ashlin4010/simple_Z80_computer/images/CF_back.jpg

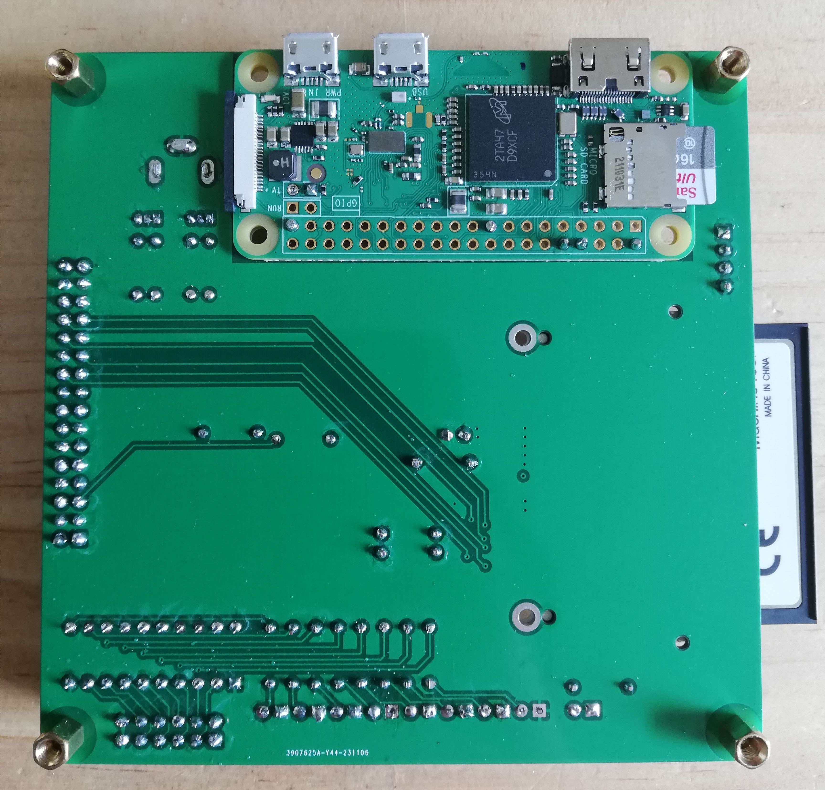
images/CF_back.jpg
