ashlin4010/simple_Z80_computer/images/CF_top.jpg

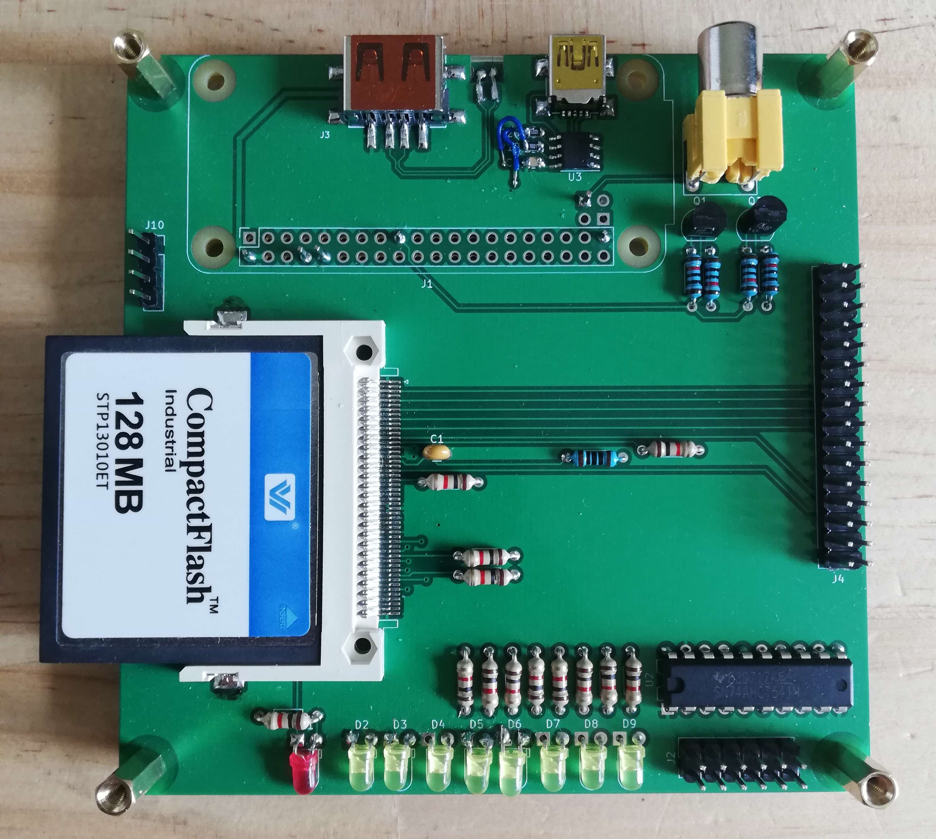
images/CF_top.jpg
