ashlin4010/simple_Z80_computer/images/Z80_back.jpg

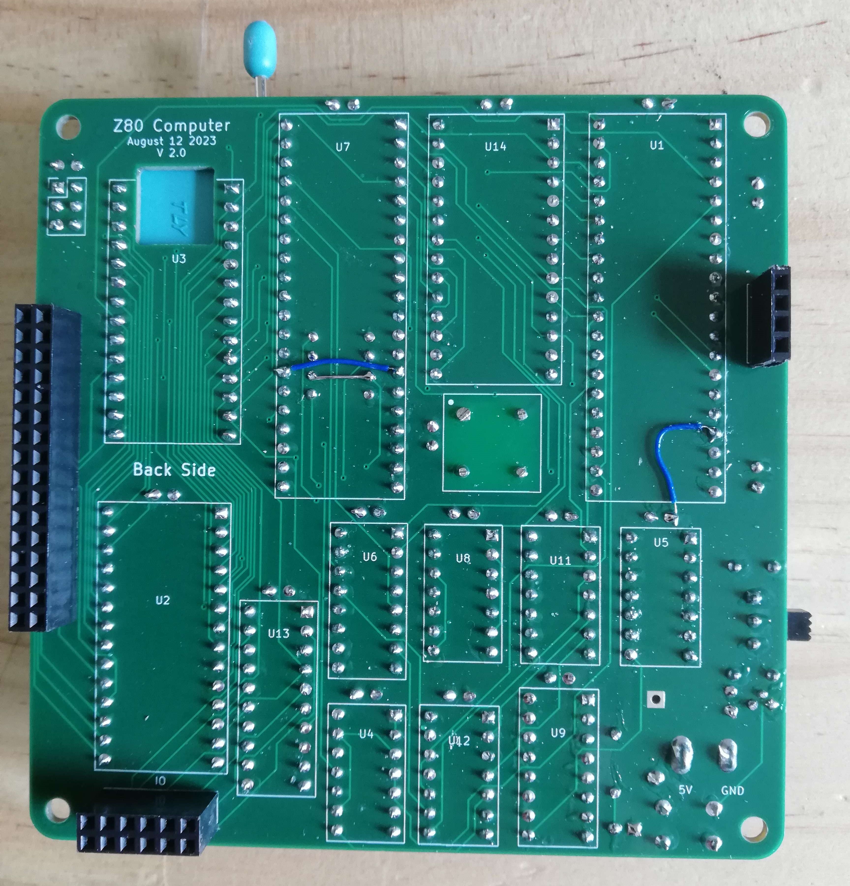
images/Z80_back.jpg
