ashlin4010/simple_Z80_computer/design_files/share/3dmodels/DC Power Jack 5.5mm x 2.1mm.STEP

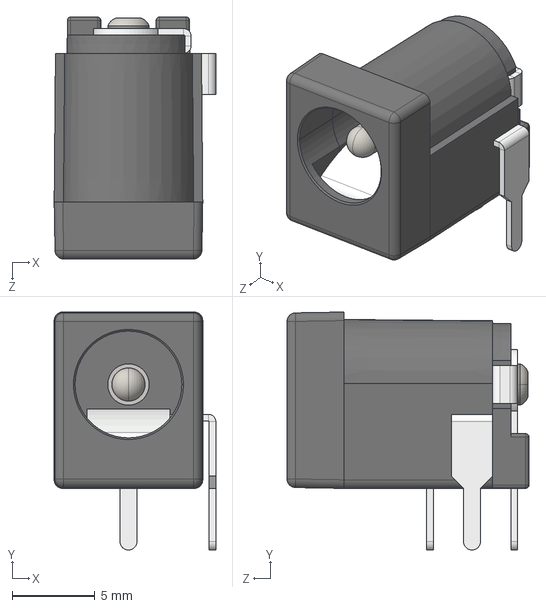
[picture p11: CAD file, 2023-12-16]
design_files/share/3dmodels/DC Power Jack 5.5mm x 2.1mm.STEP
9.77 x 14.4 x 14.6 mm
