ashlin4010/simple_Z80_computer/design_files/CompactFlash/CompactFlash.pdf

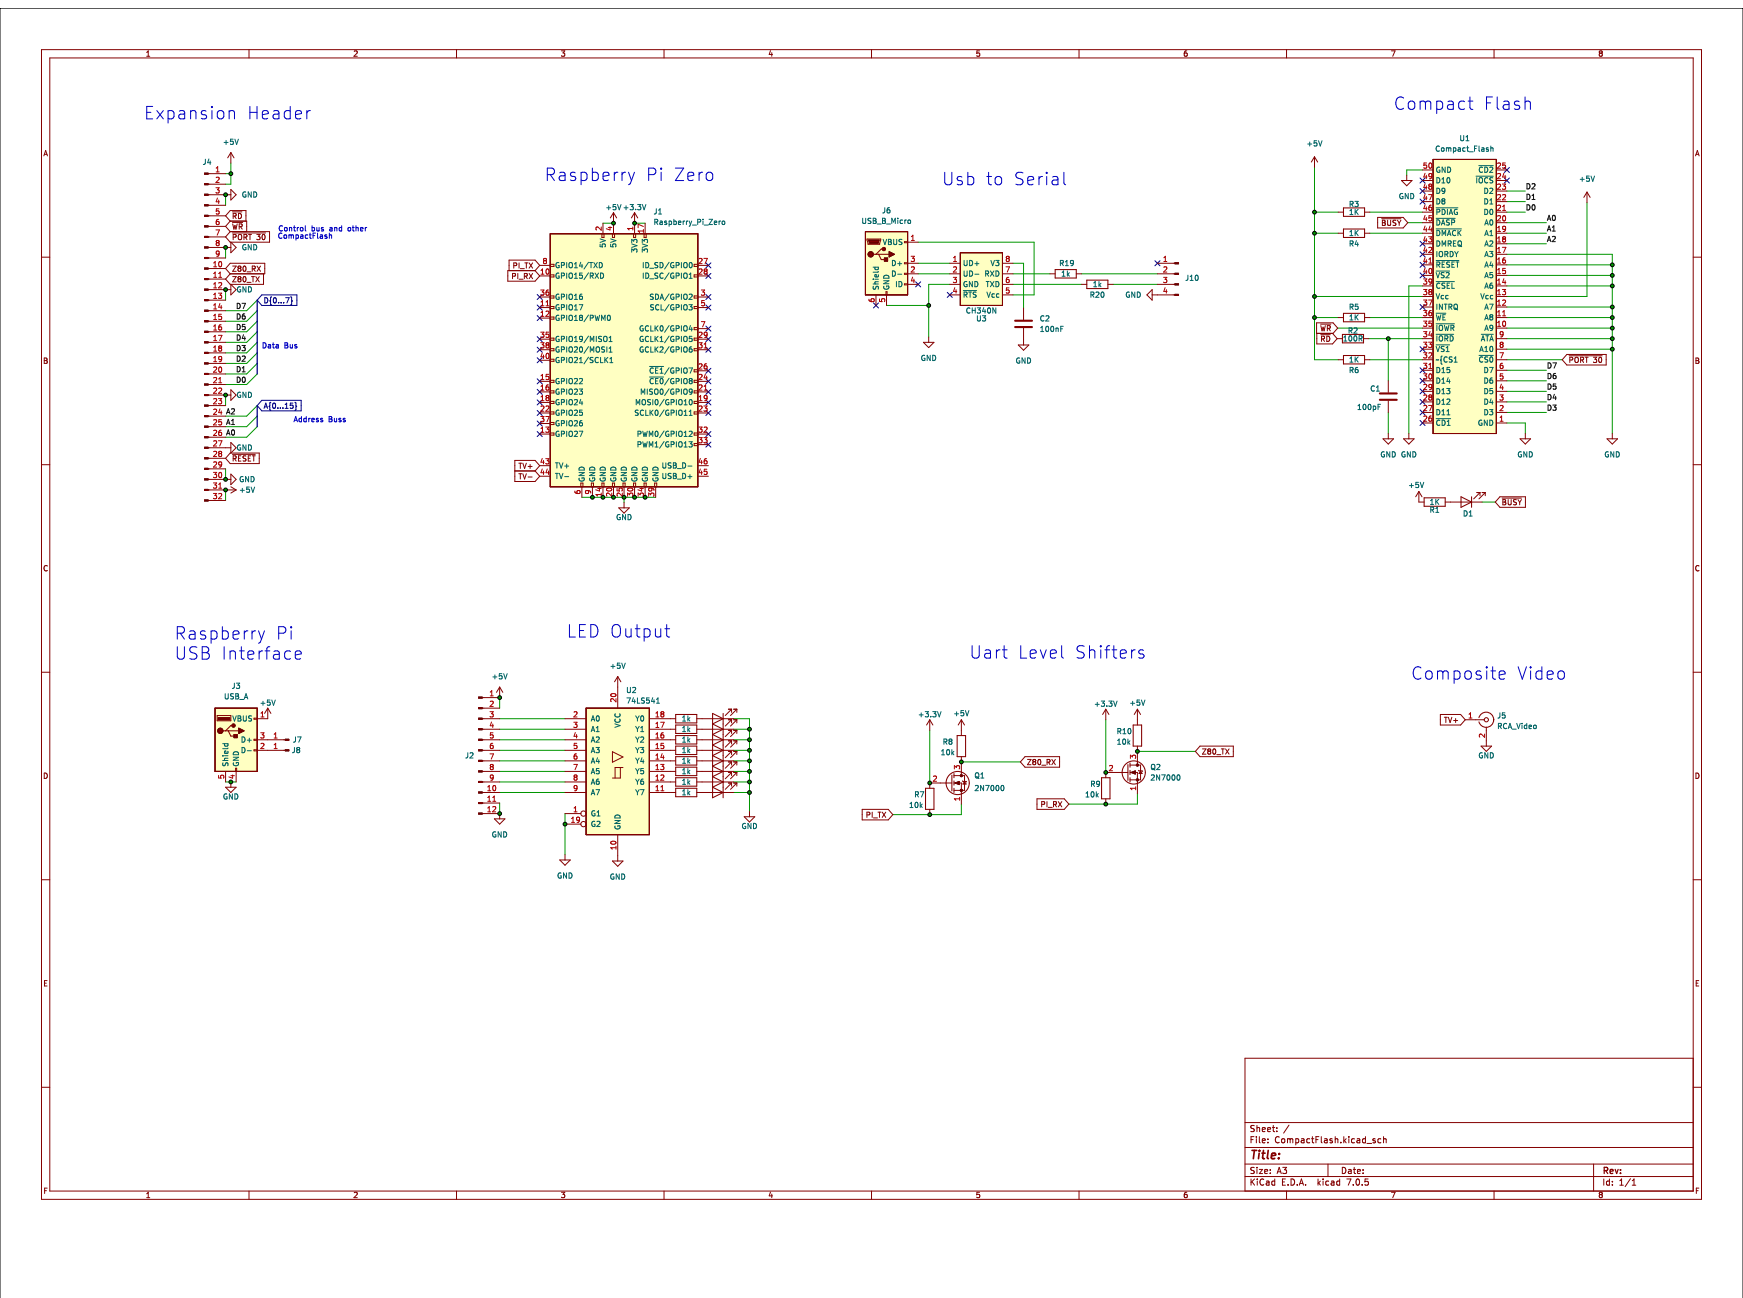
[picture p12: page 1]
