ashlin4010/simple_Z80_computer/design_files/main_board/simple_Z80.pdf

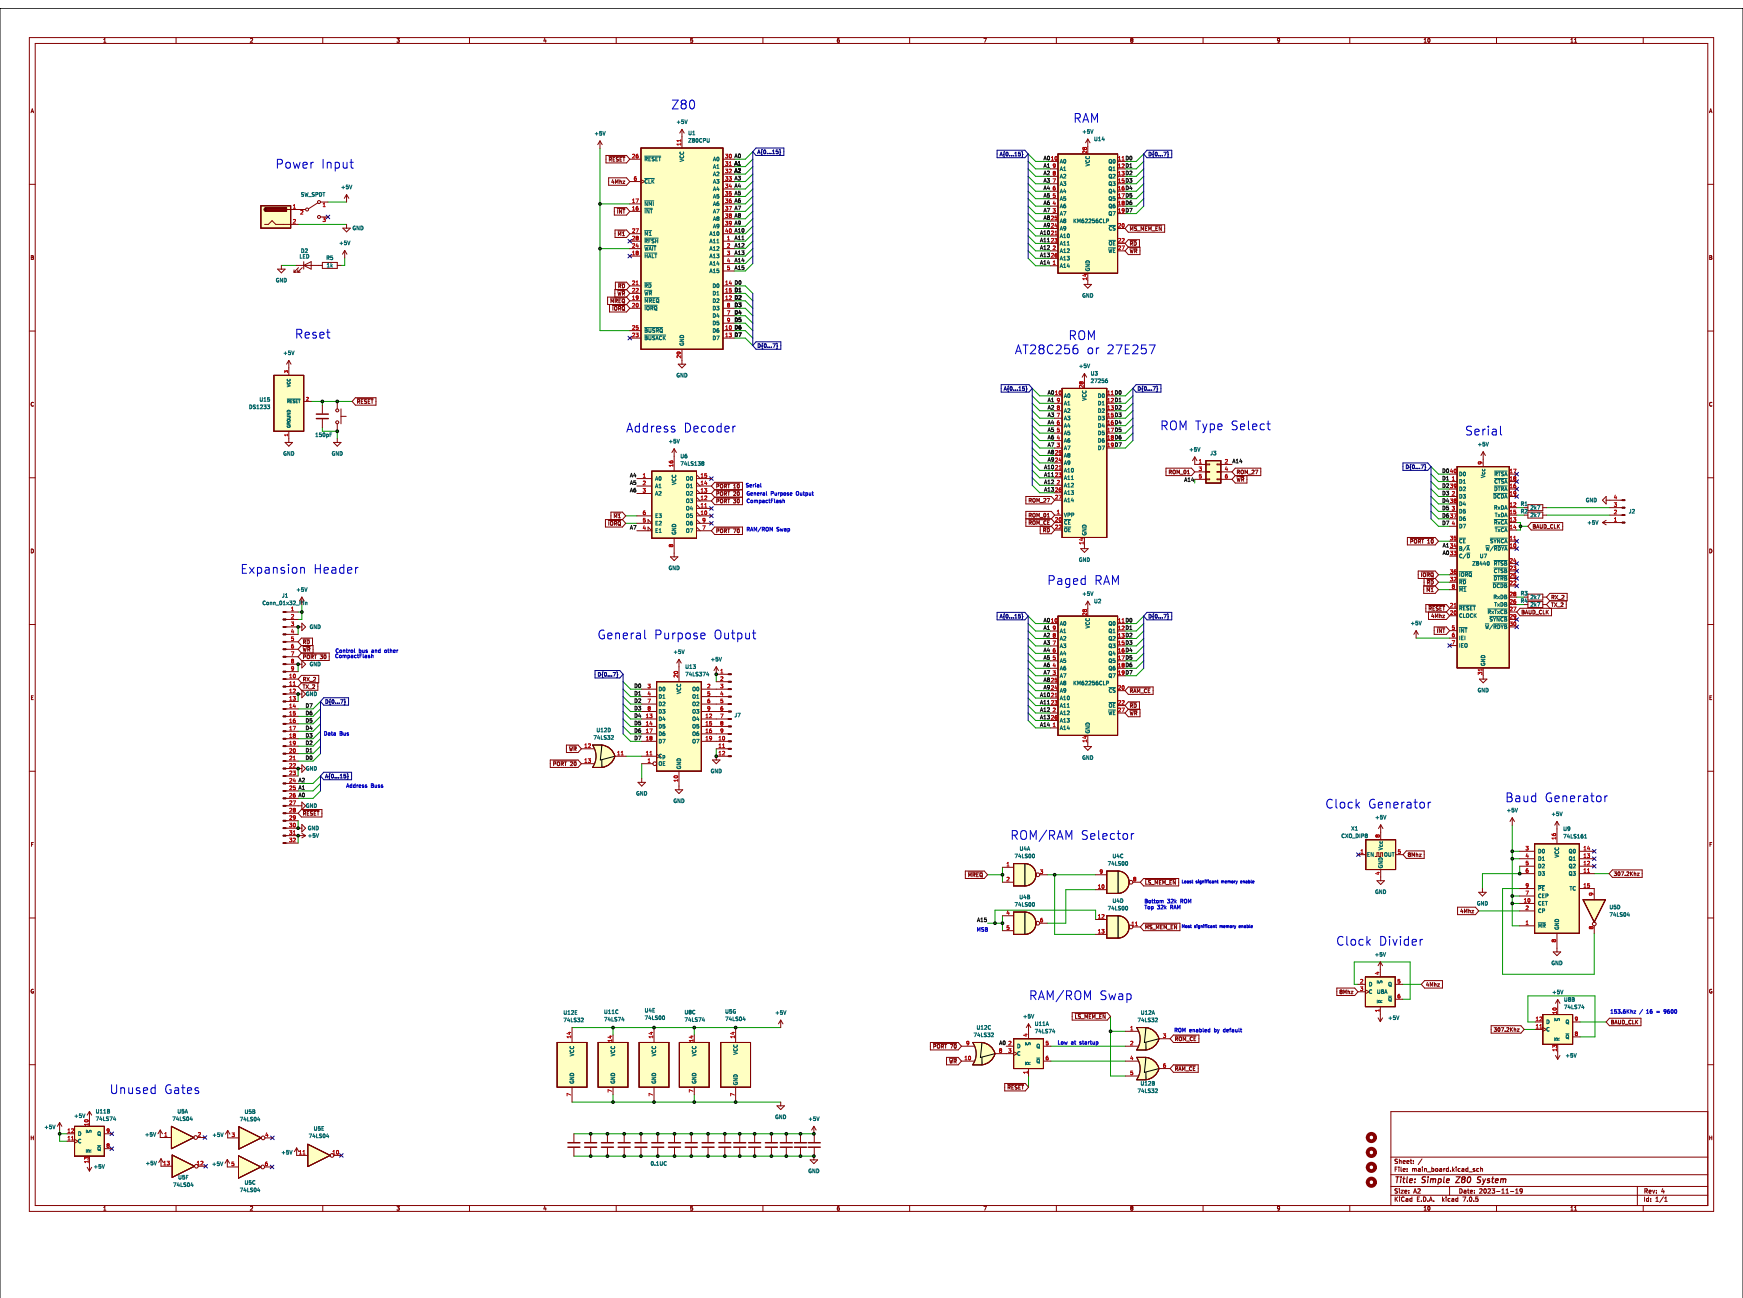
[picture p13: page 1]
