ashlin4010/simple_Z80_computer/design_files/CompactFlash/CompactFlash.kicad_pcb

## KiCad design design_files/CompactFlash/CompactFlash.kicad_pcb (2023-12-17)

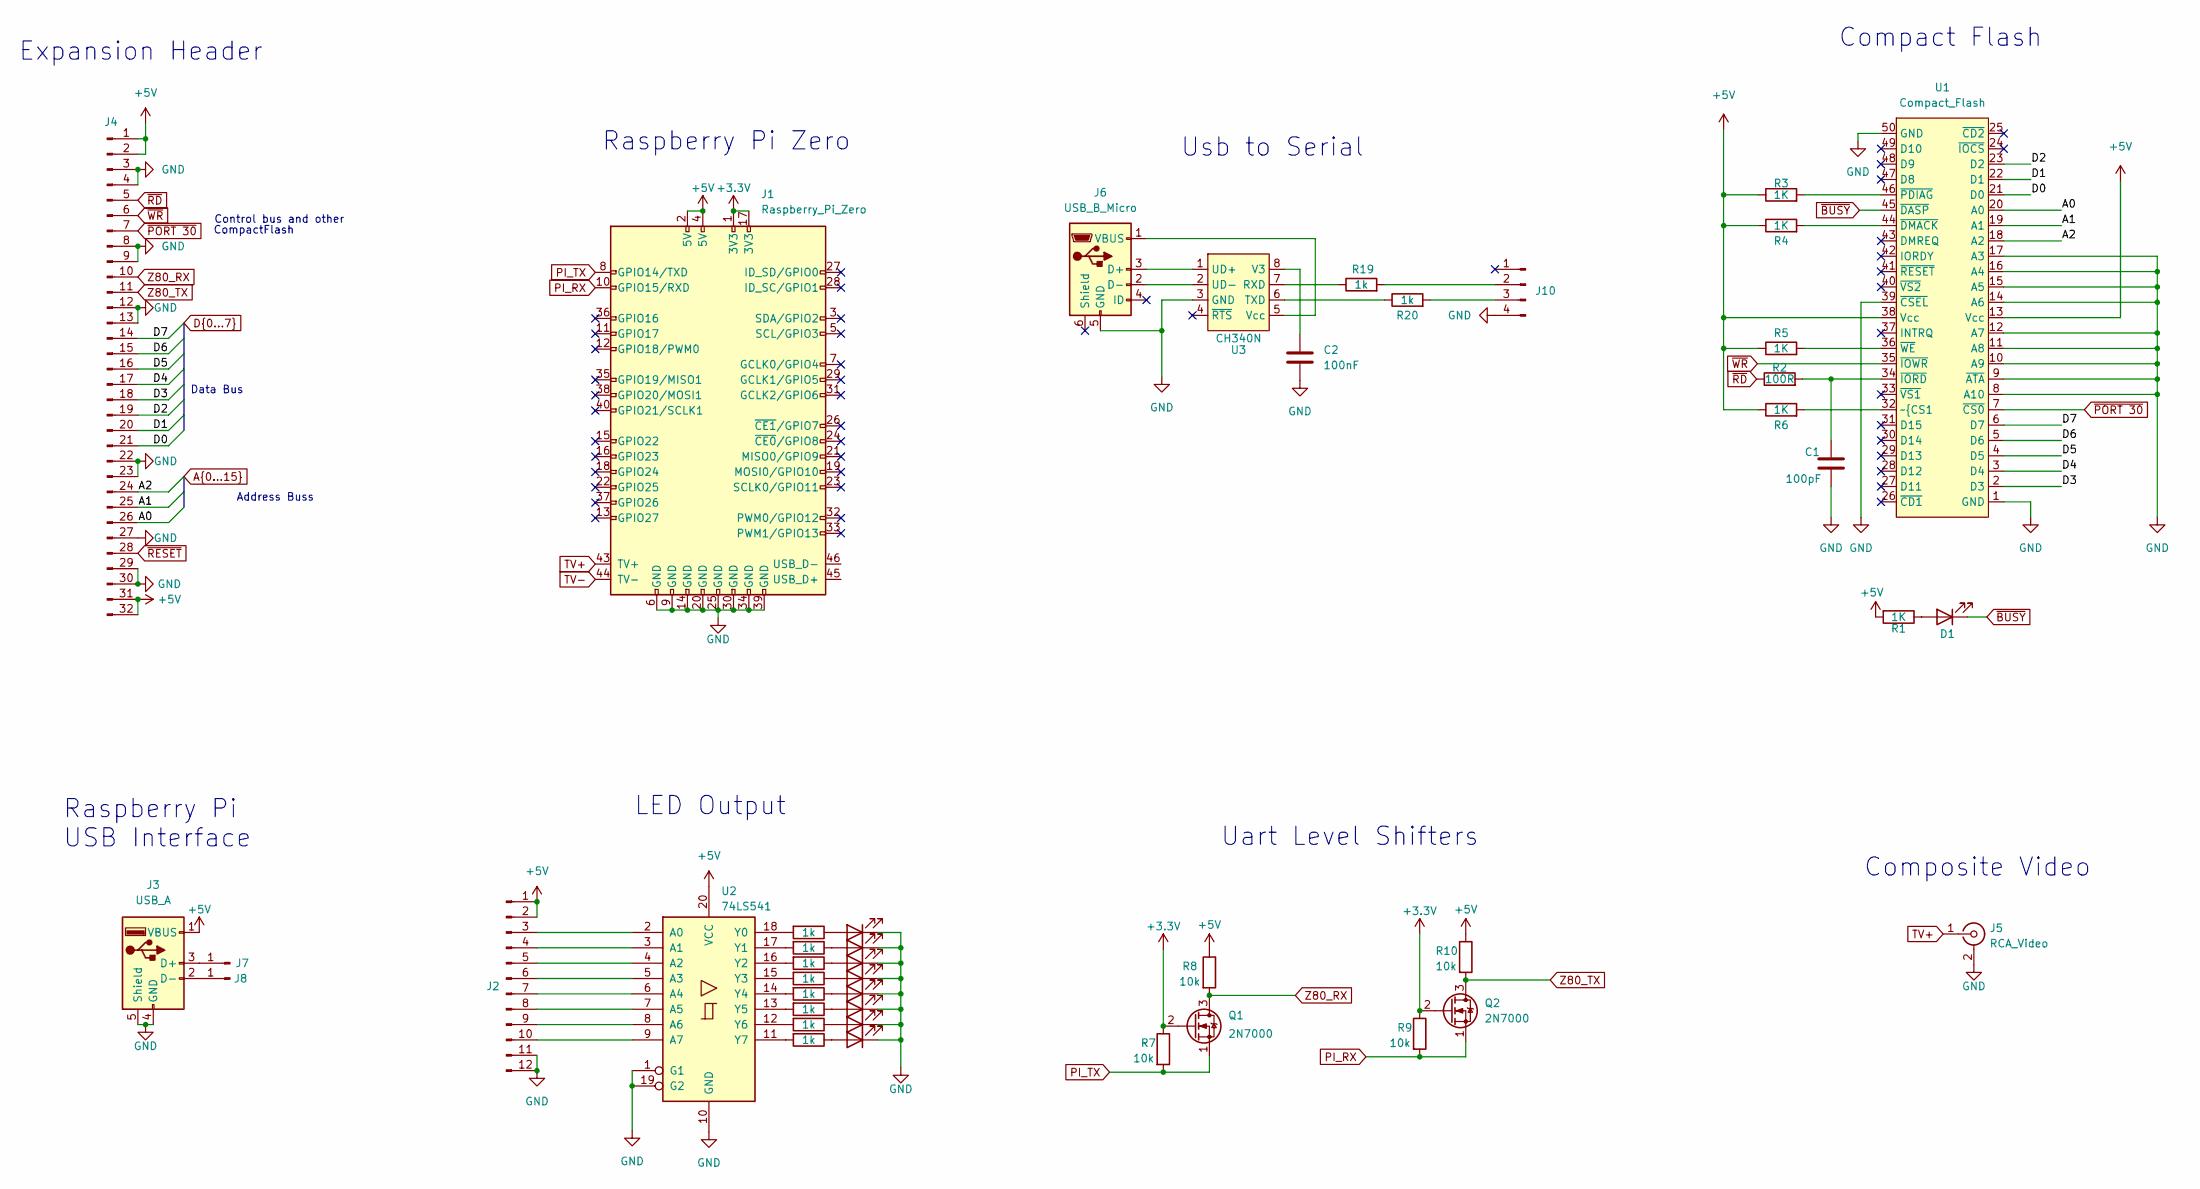
[picture p14: schematic CompactFlash.kicad_sch]

Parts:
C1: 100pF; C_Disc_D3.0mm_W1.6mm_P2.50mm
C2: 100nF; C_0805_2012Metric
D1, D2, D3, D4, D5, D6, D7, D8, D9: LED; LED_D3.0mm_Horizontal_O1.27mm_Z2.0mm
J1: Raspberry_Pi_Zero; Raspberry_Pi_Zero_Socketed_THT_FaceDown_MountingHoles
J2: Conn_01x12_Male; PinHeader_2x06_P2.54mm_Vertical
J3: USB_A; 629104190121
J4: Conn_01x32_Pin; PinSocket_2x16_P2.54mm_Vertical
J5: RCA_Video; SWITCHCRAFT_PJRAN1X1U04X
J6: USB_B_Micro; USB_Mini-B_Wuerth_65100516121_Horizontal
J7, J8: Conn_01x01_Pin; SolderWirePad_1x01_SMD_1x2mm
J10: Conn_01x04_Pin; PinSocket_1x04_P2.54mm_Vertical
Q1, Q2: 2N7000; TO-92_Inline
R1, R3, R4, R5, R6: 1K; R_Axial_DIN0204_L3.6mm_D1.6mm_P7.62mm_Horizontal
R2: 100R; R_Axial_DIN0204_L3.6mm_D1.6mm_P7.62mm_Horizontal
R7, R8, R9, R10: 10k; R_Axial_DIN0204_L3.6mm_D1.6mm_P7.62mm_Horizontal
R11, R12, R13, R14, R15, R16, R17, R18: 1k; R_Axial_DIN0204_L3.6mm_D1.6mm_P7.62mm_Horizontal
R19, R20: 1k; R_0805_2012Metric
U1: Compact_Flash; CF-Card_3M_N7E50-E516xx-30
U2: 74LS541; DIP-20_W7.62mm
U3: CH340N; SOP-8_3.9x4.9mm_P1.27mm

Connections:
+3.3V: J1.1 (3V3), J1.17 (3V3), Q1.2 (G), Q2.2 (G), R7.1, R9.1
+5V: J1.2 (5V), J1.4 (5V), J2.1, J2.2, J3.1 (VBUS), J4.1, J4.2, J4.31, J4.32, R1.2, R3.1, R4.1, R5.1, R6.1, R8.1, R10.1, U1.13 (Vcc), U1.38 (Vcc), U2.20 (VCC)
/A0: J4.26, U1.20 (A0)
/A1: J4.25, U1.19 (A1)
/A2: J4.24, U1.18 (A2)
/D0: J4.21, U1.21 (D0)
/D1: J4.20, U1.22 (D1)
/D2: J4.19, U1.23 (D2)
/D3: J4.18, U1.2 (D3)
/D4: J4.17, U1.3 (D4)
/D5: J4.16, U1.4 (D5)
/D6: J4.15, U1.5 (D6)
/D7: J4.14, U1.6 (D7)
GND: C1.2, C2.1, D2.1 (K), D3.1 (K), D4.1 (K), D5.1 (K), D6.1 (K), D7.1 (K), D8.1 (K), D9.1 (K), J1.6 (GND), J1.9 (GND), J1.14 (GND), J1.20 (GND), J1.25 (GND), J1.30 (GND), J1.34 (GND), J1.39 (GND), J2.11, J2.12, J3.4 (GND), J3.5 (Shield), J4.3, J4.4, J4.8, J4.9, J4.12, J4.13, J4.22, J4.23, J4.27, J4.29, J4.30, J5.2 (Ext), J6.5 (GND), J10.4, U1.1 (GND), U1.8 (A10), U1.9 (~ATA), U1.10 (A9), U1.11 (A8), U1.12 (A7), U1.14 (A6), U1.15 (A5), U1.16 (A4), U1.17 (A3), U1.39 (~CSEL), U1.50 (GND), U2.1 (G1), U2.10 (GND), U2.19 (G2), U3.3 (GND)
unnamed: D1.2 (A), R1.1
unnamed: D2.2 (A), R11.1
unnamed: D3.2 (A), R12.1
unnamed: D4.2 (A), R13.1
unnamed: D5.2 (A), R14.1
unnamed: D6.2 (A), R15.1
unnamed: D7.2 (A), R16.1
unnamed: D8.2 (A), R17.1
unnamed: D9.2 (A), R18.1
unnamed: J2.3, U2.2 (A0)
unnamed: J2.4, U2.3 (A1)
unnamed: J2.5, U2.4 (A2)
unnamed: J2.6, U2.5 (A3)
unnamed: J2.7, U2.6 (A4)
unnamed: J2.8, U2.7 (A5)
unnamed: J2.9, U2.8 (A6)
unnamed: J2.10, U2.9 (A7)
unnamed: J3.3 (D+), J7.1
unnamed: J3.2 (D-), J8.1
unnamed: J6.3 (D+), U3.1 (UD+)
unnamed: J6.2 (D-), U3.2 (UD-)
unnamed: J6.1 (VBUS), U3.5 (Vcc)
unnamed: J10.2, R19.2
unnamed: J10.3, R20.2
unnamed: R6.2, U1.32 (~{CS1)
unnamed: R4.2, U1.44 (~DMACK)
unnamed: C1.1, R2.2, U1.34 (~IORD)
unnamed: R3.2, U1.46 (~PDIAG)
unnamed: R5.2, U1.36 (~WE)
unnamed: R11.2, U2.18 (Y0)
unnamed: R12.2, U2.17 (Y1)
unnamed: R13.2, U2.16 (Y2)
unnamed: R14.2, U2.15 (Y3)
unnamed: R15.2, U2.14 (Y4)
unnamed: R16.2, U2.13 (Y5)
unnamed: R17.2, U2.12 (Y6)
unnamed: R18.2, U2.11 (Y7)
unnamed: R19.1, U3.7 (RXD)
unnamed: R20.1, U3.6 (TXD)
unnamed: C2.2, U3.8 (V3)
PI_RX: J1.10 (GPIO15/RXD), Q2.1 (S), R9.2
PI_TX: J1.8 (GPIO14/TXD), Q1.1 (S), R7.2
TV+: J1.43 (TV+), J5.1 (In)
TV-: J1.44 (TV-)
Z80_RX: J4.10, Q1.3 (D), R8.2
Z80_TX: J4.11, Q2.3 (D), R10.2
~BUSY: D1.1 (K), U1.45 (~DASP)
~PORT 30: J4.7, U1.7 (~CS0)
~RD: J4.5, R2.1
~RESET: J4.28
~WR: J4.6, U1.35 (~IOWR)

Notes on the sheet:
Usb to Serial
Compact Flash
CompactFlash
Control bus and other
Raspberry Pi USB Interface
Composite Video
Uart Level Shifters
Data Bus
Address Buss
LED Output
Raspberry Pi Zero
Expansion Header

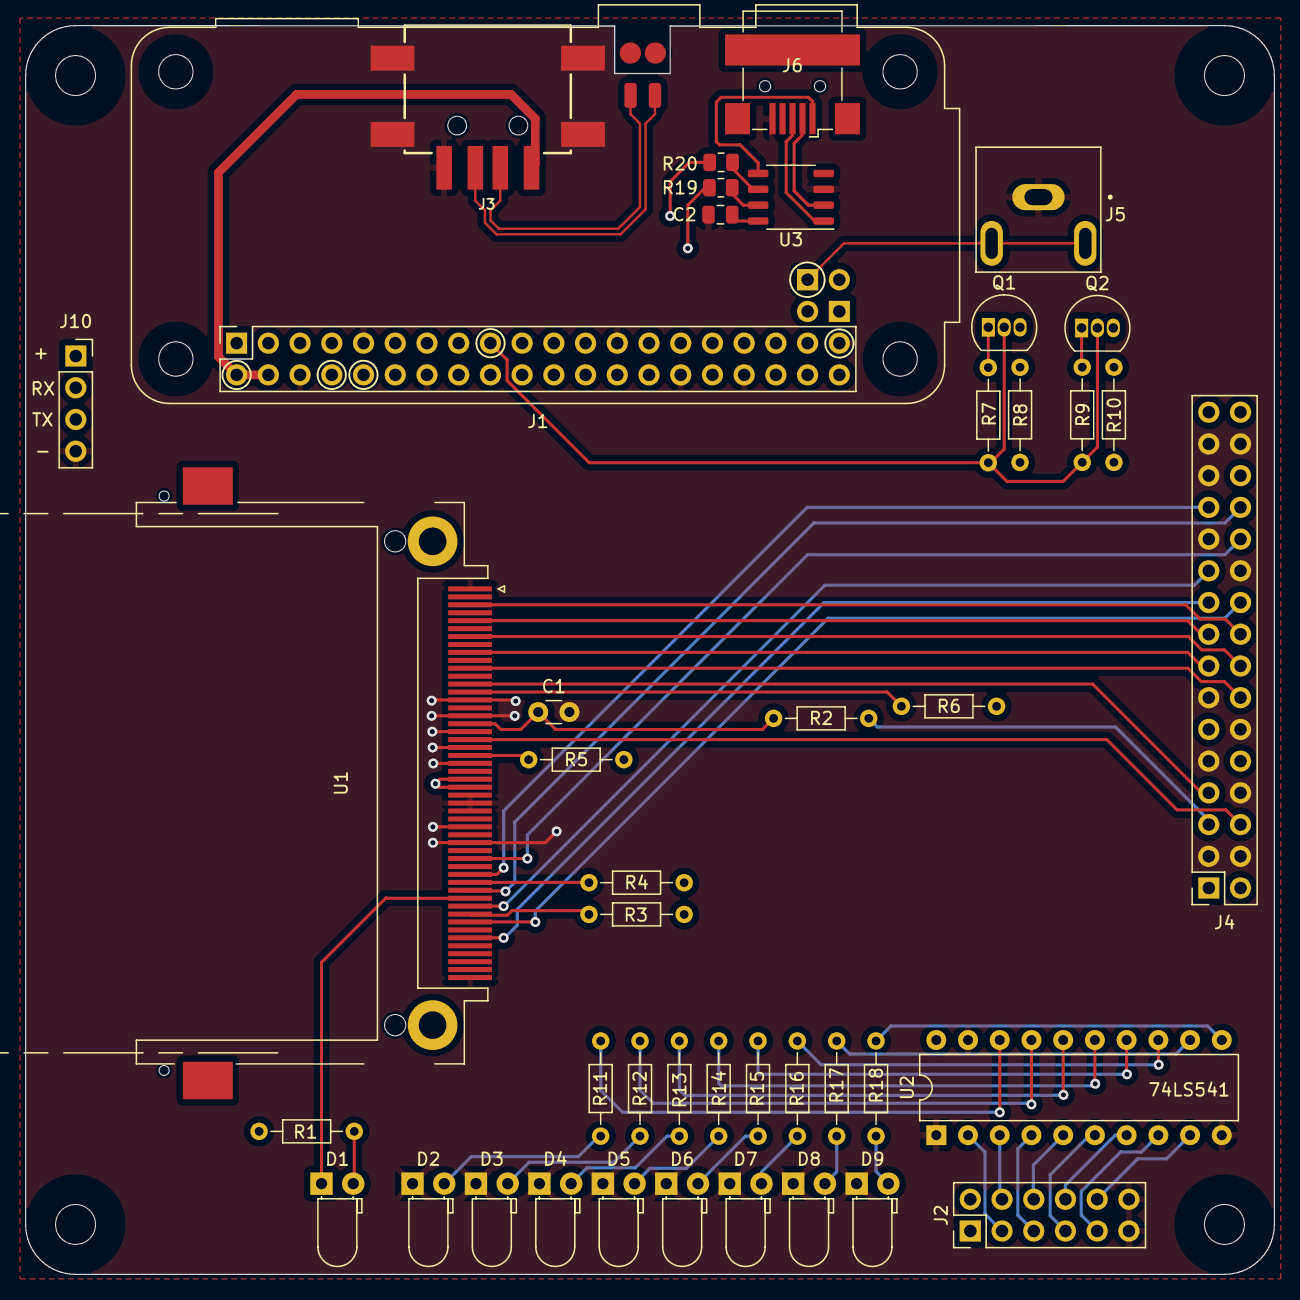
[picture p15: board CompactFlash.kicad_pcb from above]

Board: 4 copper layers, 100.0 x 100.0 mm, 49 parts (0 on the bottom side), 63 nets.

Other parts of the board:
H1, H2, H3, H4: MountingHole; MountingHole_3.2mm_M3
