ashlin4010/simple_Z80_computer/design_files/main_board/main_board.kicad_pcb

## KiCad design design_files/main_board/main_board.kicad_pcb (2023-12-16)

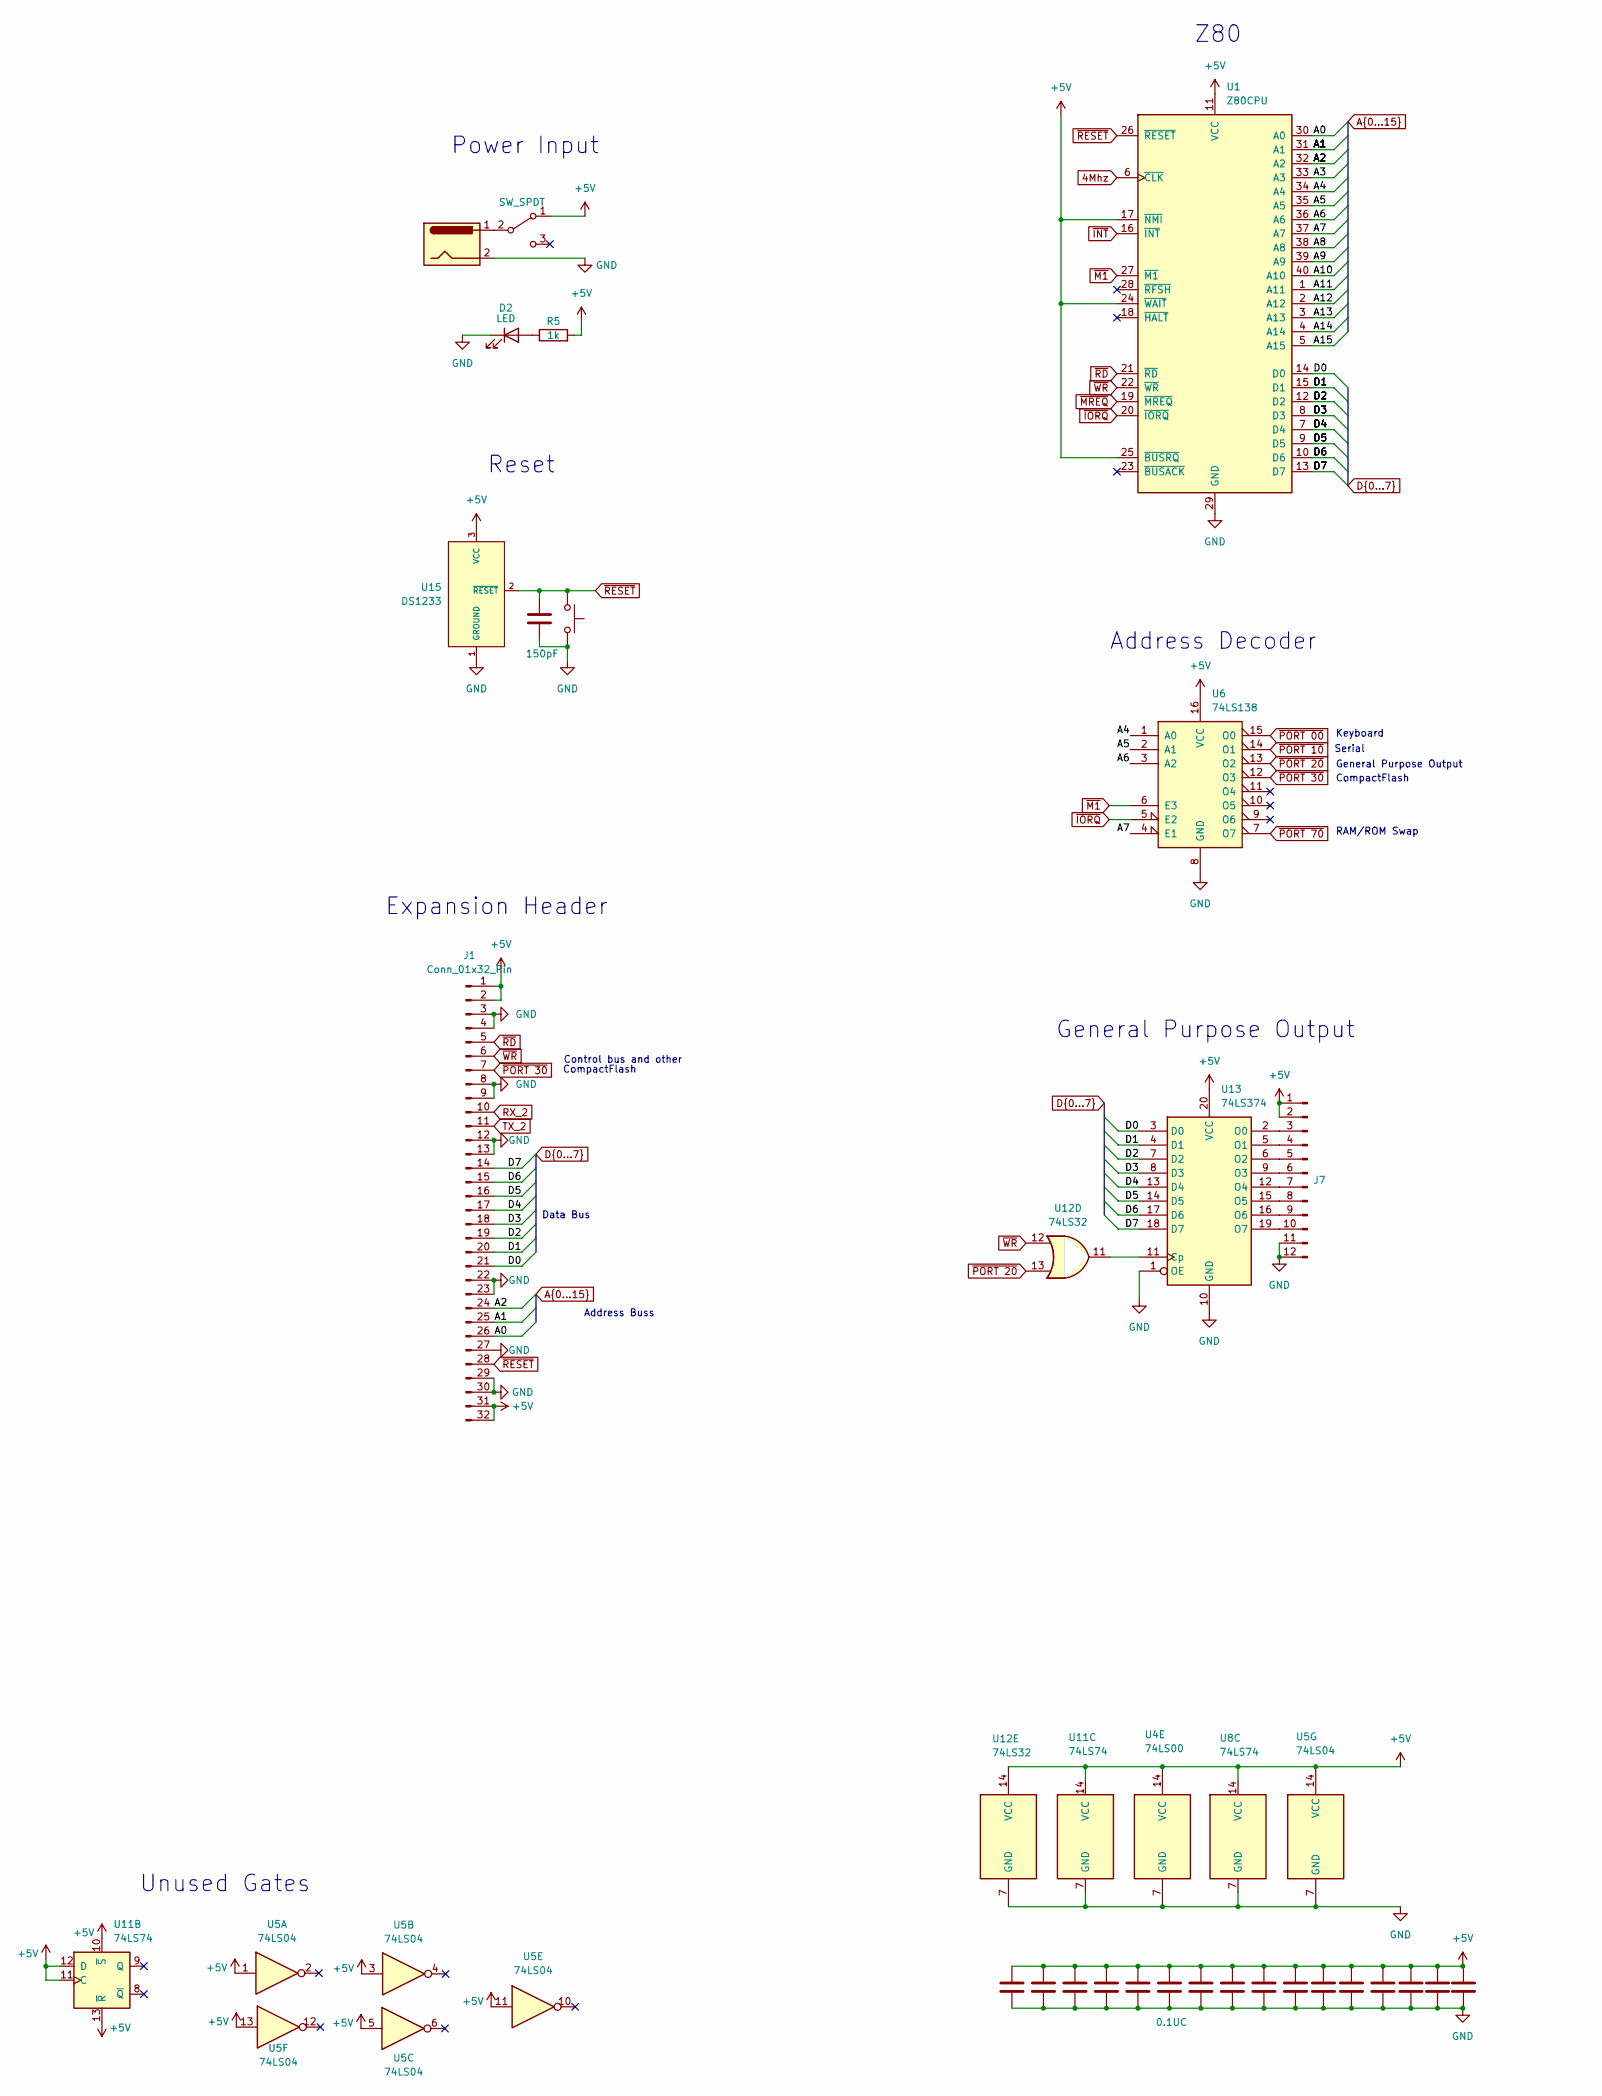
[picture p16: schematic main_board.kicad_sch, Simple Z80 System, part in row 1, column 1]

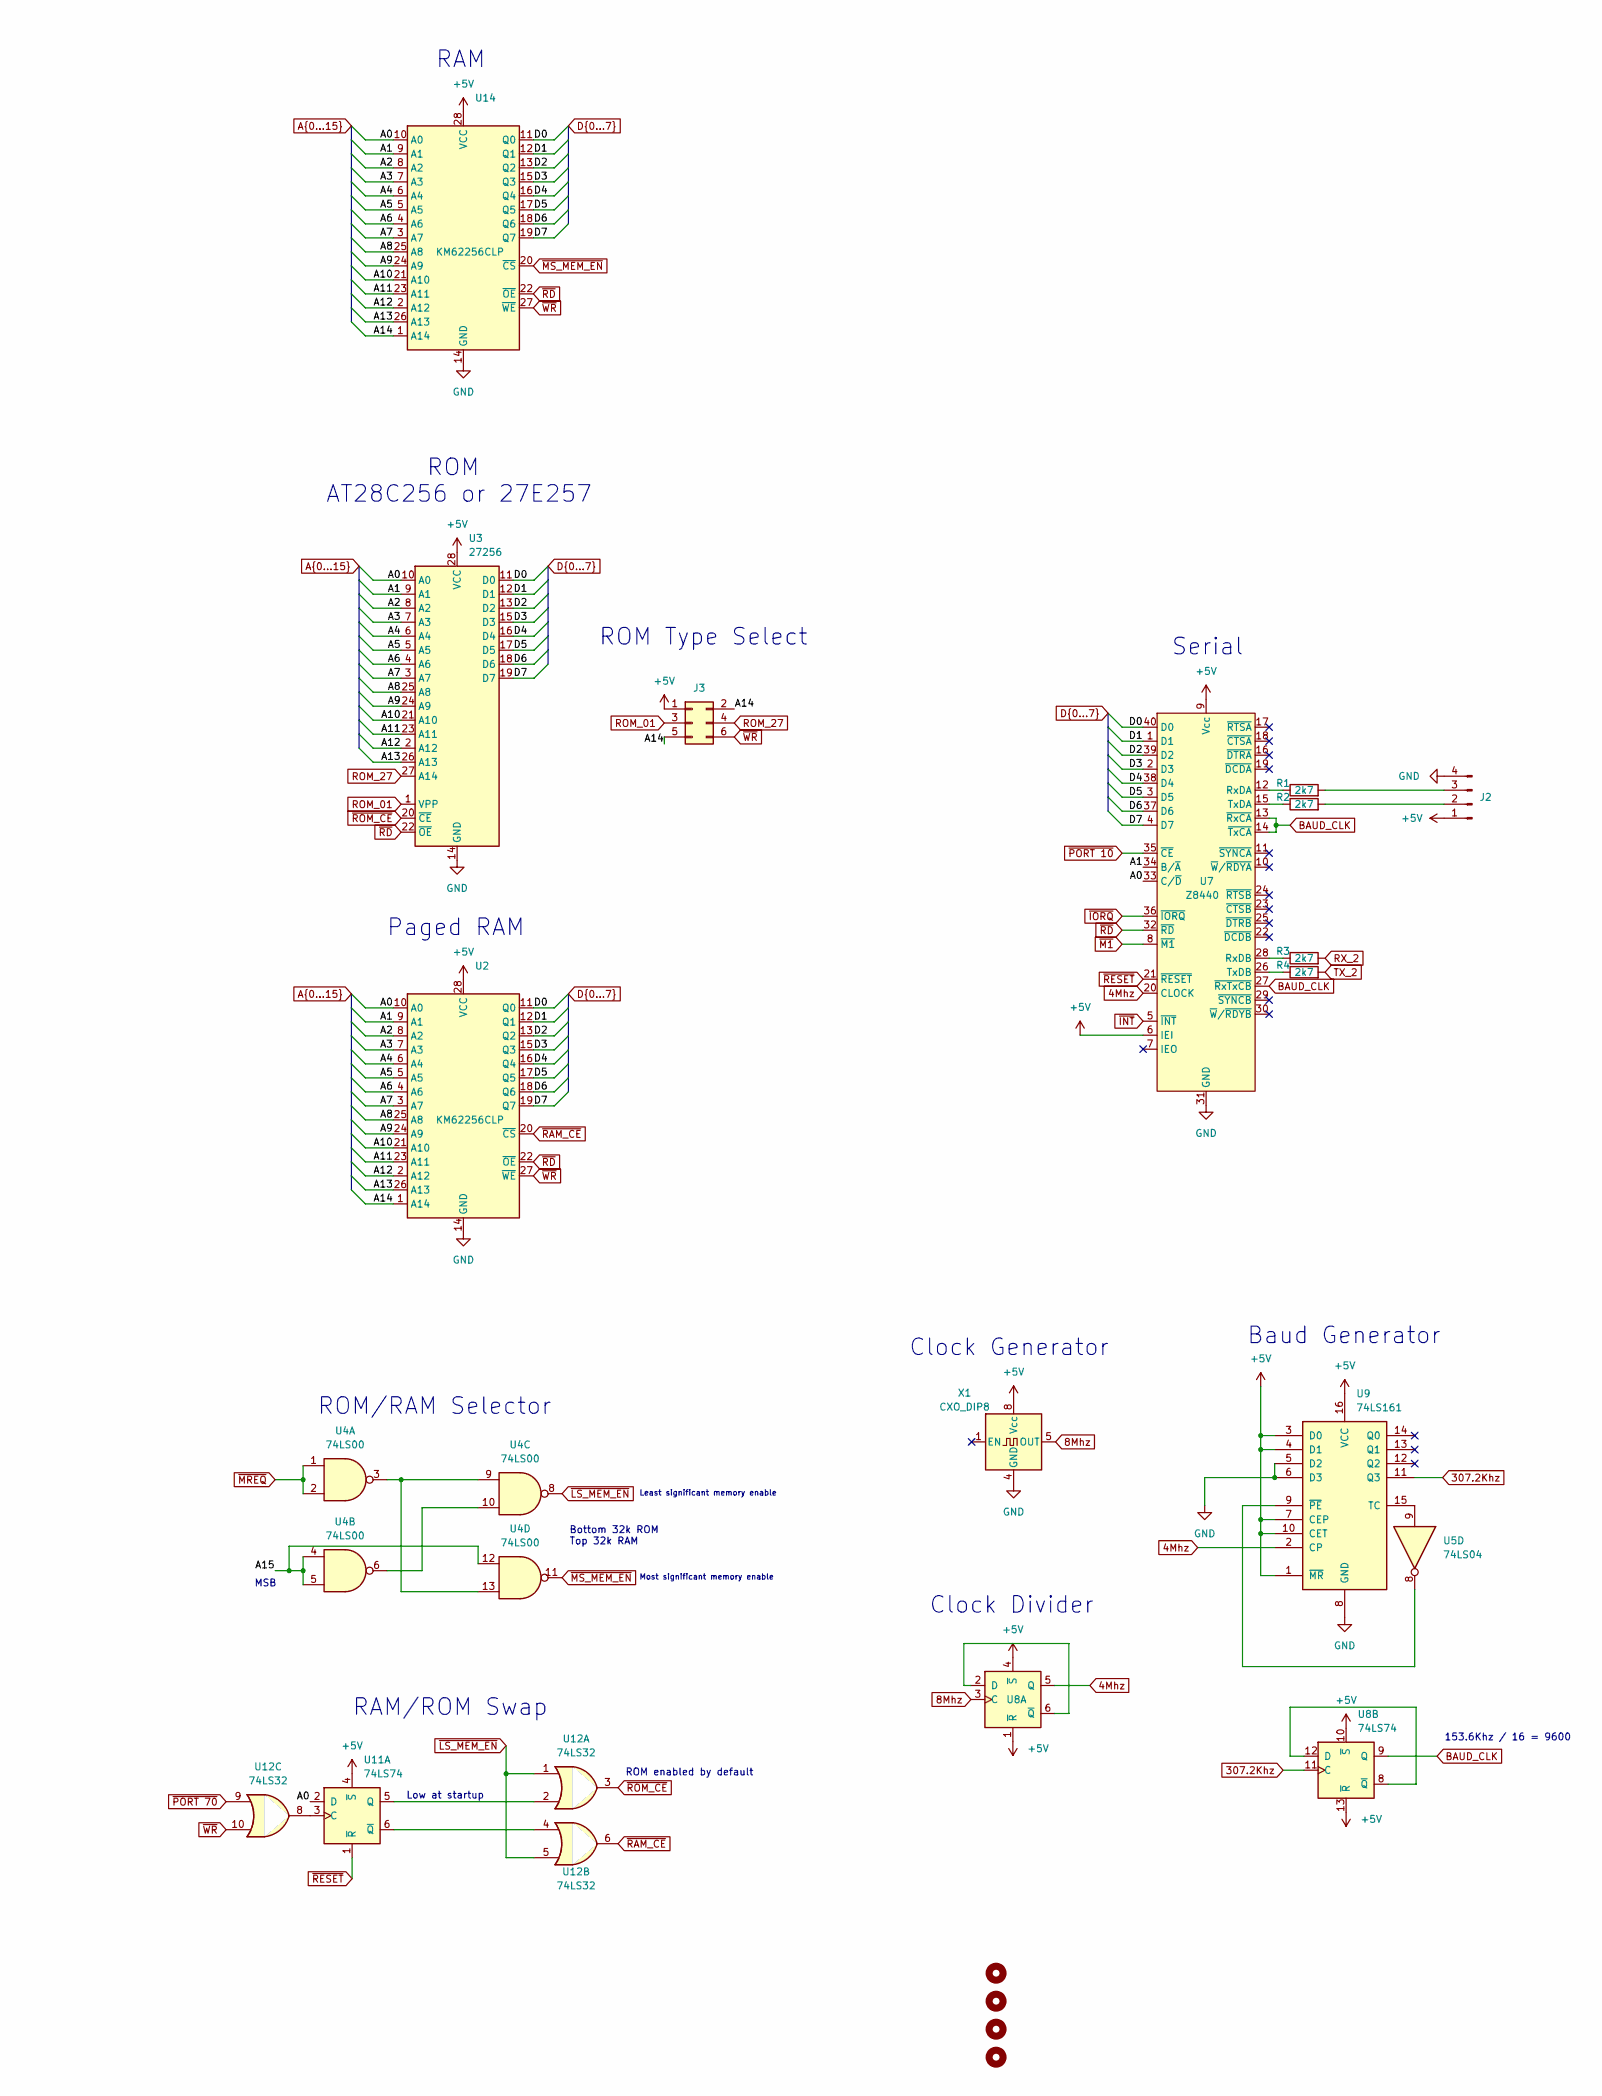
[picture p17: schematic main_board.kicad_sch, Simple Z80 System, part in row 1, column 2]

Parts:
C1: 150pF; C_Disc_D3.0mm_W1.6mm_P2.50mm
C2, C3, C4, C5, C6, C7, C8, C9, C10, C11, C12, C13, C14, C15, C16, C17: 0.1UC; C_Disc_D3.0mm_W1.6mm_P2.50mm
D2: LED; LED_D3.0mm
H1, H2, H3, H4: MountingHole; MountingHole_3.2mm_M3
J1: Conn_01x32_Pin; PinSocket_2x16_P2.54mm_Vertical
J2: Conn_01x04_Male; PinHeader_1x04_P2.54mm_Vertical
J3: Conn_02x03_Odd_Even; PinHeader_2x03_P2.54mm_Vertical
J4: Jack-DC; BarrelJack_CUI_PJ-037A
J7: Conn_01x12_Male; PinSocket_2x06_P2.54mm_Vertical
R1, R2, R3, R4: 2k7; R_Axial_DIN0204_L3.6mm_D1.6mm_P7.62mm_Horizontal
R5: 1k; R_Axial_DIN0204_L3.6mm_D1.6mm_P7.62mm_Horizontal
SW1: SW_Push; SW_PUSH_6mm_H4.3mm
SW2: SW_SPDT; SW_THT_SK-12F17-G_7-0
U1: Z80CPU; DIP-40_W15.24mm_Socket
U2: KM62256CLP; DIP-28_W15.24mm_Socket
U3: 27256; DIP_Socket-28_W11.9_W12.7_W15.24_W17.78_W18.5_3M_228-1277-0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
U4: 74LS00; DIP-14_W7.62mm_Socket
U5: 74LS04; DIP-14_W7.62mm_Socket
U6: 74LS138; DIP-16_W7.62mm_Socket
U7: Z8440; DIP-40_W15.24mm
U8, U11: 74LS74; DIP-14_W7.62mm_Socket
U9: 74LS161; DIP-16_W7.62mm_Socket
U12: 74LS32; DIP-14_W7.62mm_Socket
U13: 74LS374; DIP-20_W7.62mm_Socket
U14: KM62256CLP; DIP-28_W15.24mm
U15: DS1233; TO-92
X1: CXO_DIP8; Oscillator_DIP-8

Connections:
4Mhz: U1.6 (~CLK), U7.20 (CLOCK), U8.5 (Q), U9.2 (CP)
8Mhz: U8.3 (C), X1.5 (OUT)
307.2Khz: U8.11 (C), U9.11 (Q3)
+5V: C2.1, C3.1, C4.1, C5.1, C6.1, C7.1, C8.1, C9.1, C10.1, C11.1, C12.1, C13.1, C14.1, C15.1, C16.1, C17.1, J1.1, J1.2, J1.31, J1.32, J2.1, J3.1, J7.1, J7.2, R5.2, SW2.1 (A), U1.11 (VCC), U1.17 (~NMI), U1.24 (~WAIT), U1.25 (~BUSRQ), U2.28 (VCC), U3.28 (VCC), U4.14 (VCC), U5.1, U5.3, U5.5, U5.11, U5.13, U5.14 (VCC), U6.16 (VCC), U7.6 (IEI), U7.9 (Vcc), U8.1 (~R), U8.4 (~S), U8.10 (~S), U8.13 (~R), U8.14 (VCC), U9.1 (~MR), U9.3 (D0), U9.4 (D1), U9.7 (CEP), U9.10 (CET), U9.16 (VCC), U11.4 (~S), U11.10 (~S), U11.11 (C), U11.12 (D), U11.13 (~R), U11.14 (VCC), U12.14 (VCC), U13.20 (VCC), U14.28 (VCC), U15.3 (VCC), X1.8 (Vcc)
/A0: J1.26, U1.30 (A0), U2.10 (A0), U3.10 (A0), U7.33 (C/~D), U11.2 (D), U14.10 (A0)
/A1: J1.25, U1.31 (A1), U2.9 (A1), U3.9 (A1), U7.34 (B/~A), U14.9 (A1)
/A2: J1.24, U1.32 (A2), U2.8 (A2), U3.8 (A2), U14.8 (A2)
/A3: U1.33 (A3), U2.7 (A3), U3.7 (A3), U14.7 (A3)
/A4: U1.34 (A4), U2.6 (A4), U3.6 (A4), U6.1 (A0), U14.6 (A4)
/A5: U1.35 (A5), U2.5 (A5), U3.5 (A5), U6.2 (A1), U14.5 (A5)
/A6: U1.36 (A6), U2.4 (A6), U3.4 (A6), U6.3 (A2), U14.4 (A6)
/A7: U1.37 (A7), U2.3 (A7), U3.3 (A7), U6.4 (E1), U14.3 (A7)
/A8: U1.38 (A8), U2.25 (A8), U3.25 (A8), U14.25 (A8)
/A9: U1.39 (A9), U2.24 (A9), U3.24 (A9), U14.24 (A9)
/A10: U1.40 (A10), U2.21 (A10), U3.21 (A10), U14.21 (A10)
/A11: U1.1 (A11), U2.23 (A11), U3.23 (A11), U14.23 (A11)
/A12: U1.2 (A12), U2.2 (A12), U3.2 (A12), U14.2 (A12)
/A13: U1.3 (A13), U2.26 (A13), U3.26 (A13), U14.26 (A13)
/A14: J3.2, J3.5, U1.4 (A14), U2.1 (A14), U14.1 (A14)
/A15: U1.5 (A15), U4.4, U4.5, U4.12
/D0: J1.21, U1.14 (D0), U2.11 (Q0), U3.11 (D0), U7.40 (D0), U13.3 (D0), U14.11 (Q0)
/D1: J1.20, U1.15 (D1), U2.12 (Q1), U3.12 (D1), U7.1 (D1), U13.4 (D1), U14.12 (Q1)
/D2: J1.19, U1.12 (D2), U2.13 (Q2), U3.13 (D2), U7.39 (D2), U13.7 (D2), U14.13 (Q2)
/D3: J1.18, U1.8 (D3), U2.15 (Q3), U3.15 (D3), U7.2 (D3), U13.8 (D3), U14.15 (Q3)
/D4: J1.17, U1.7 (D4), U2.16 (Q4), U3.16 (D4), U7.38 (D4), U13.13 (D4), U14.16 (Q4)
/D5: J1.16, U1.9 (D5), U2.17 (Q5), U3.17 (D5), U7.3 (D5), U13.14 (D5), U14.17 (Q5)
/D6: J1.15, U1.10 (D6), U2.18 (Q6), U3.18 (D6), U7.37 (D6), U13.17 (D6), U14.18 (Q6)
/D7: J1.14, U1.13 (D7), U2.19 (Q7), U3.19 (D7), U7.4 (D7), U13.18 (D7), U14.19 (Q7)
BAUD_CLK: U7.13 (~RxCA), U7.14 (~TxCA), U7.27 (~RxTxCB), U8.9 (Q)
GND: C1.2, C2.2, C3.2, C4.2, C5.2, C6.2, C7.2, C8.2, C9.2, C10.2, C11.2, C12.2, C13.2, C14.2, C15.2, C16.2, C17.2, D2.1 (K), J1.3, J1.4, J1.8, J1.9, J1.12, J1.13, J1.22, J1.23, J1.27, J1.29, J1.30, J2.4, J4.2, J7.11, J7.12, SW1.2, U1.29 (GND), U2.14 (GND), U3.14 (GND), U4.7 (GND), U5.7 (GND), U6.8 (GND), U7.31 (GND), U8.7 (GND), U9.5 (D2), U9.6 (D3), U9.8 (GND), U11.7 (GND), U12.7 (GND), U13.1 (OE), U13.10 (GND), U14.14 (GND), U15.1 (GROUND), X1.4 (GND)
unnamed: D2.2 (A), R5.1
unnamed: J2.2, R2.2
unnamed: J2.3, R1.2
unnamed: J7.3, U13.2 (O0)
unnamed: J7.4, U13.5 (O1)
unnamed: J7.5, U13.6 (O2)
unnamed: J7.6, U13.9 (O3)
unnamed: J7.7, U13.12 (O4)
unnamed: J7.8, U13.15 (O5)
unnamed: J7.9, U13.16 (O6)
unnamed: J7.10, U13.19 (O7)
unnamed: J4.1, SW2.2 (B)
unnamed: U4.6, U4.10
unnamed: U4.3, U4.9, U4.13
unnamed: R1.1, U7.12 (RxDA)
unnamed: R3.1, U7.28 (RxDB)
unnamed: R2.1, U7.15 (TxDA)
unnamed: R4.1, U7.26 (TxDB)
unnamed: U8.2 (D), U8.6 (~Q)
unnamed: U8.8 (~Q), U8.12 (D)
unnamed: U5.9, U9.15 (TC)
unnamed: U5.8, U9.9 (~PE)
unnamed: U11.3 (C), U12.8
unnamed: U11.5 (Q), U12.2
unnamed: U11.6 (~Q), U12.4
unnamed: U12.11, U13.11 (Cp)
ROM_01: J3.3, U3.1 (VPP)
ROM_27: J3.4, U3.27 (A14)
RX_2: J1.10, R3.2
TX_2: J1.11, R4.2
~INT: U1.16 (~INT), U7.5 (~INT)
~IORQ: U1.20 (~IORQ), U6.5 (E2), U7.36 (~IORQ)
~LS_MEM_EN: U4.8, U12.1, U12.5
~M1: U1.27 (~M1), U6.6 (E3), U7.8 (~M1)
~MREQ: U1.19 (~MREQ), U4.1, U4.2
~MS_MEM_EN: U4.11, U14.20 (~CS)
~PORT 00: U6.15 (O0)
~PORT 10: U6.14 (O1), U7.35 (~CE)
~PORT 20: U6.13 (O2), U12.13
~PORT 30: J1.7, U6.12 (O3)
~PORT 70: U6.7 (O7), U12.9
~RAM_CE: U2.20 (~CS), U12.6
~RD: J1.5, U1.21 (~RD), U2.22 (~OE), U3.22 (~OE), U7.32 (~RD), U14.22 (~OE)
~RESET: C1.1, J1.28, SW1.1, U1.26 (~RESET), U7.21 (~RESET), U11.1 (~R), U15.2 (~RESET)
~ROM_CE: U3.20 (~CE), U12.3
~WR: J1.6, J3.6, U1.22 (~WR), U2.27 (~WE), U12.10, U12.12, U14.27 (~WE)

Notes on the sheet:
RAM/ROM Swap
Most significant memory enable
ROM/RAM Selector
RAM
Z80
Reset
Serial
ROM Type Select
Address Buss
Baud Generator
Least significant memory enable
CompactFlash
Clock Generator
General Purpose Output
Bottom 32k ROM Top 32k RAM
Paged RAM
MSB
Clock Divider
Keyboard
Low at startup
Data Bus
153.6Khz / 16 = 9600
ROM AT28C256 or 27E257
Expansion Header
Address Decoder
ROM enabled by default
Unused Gates
Control bus and other
Power Input

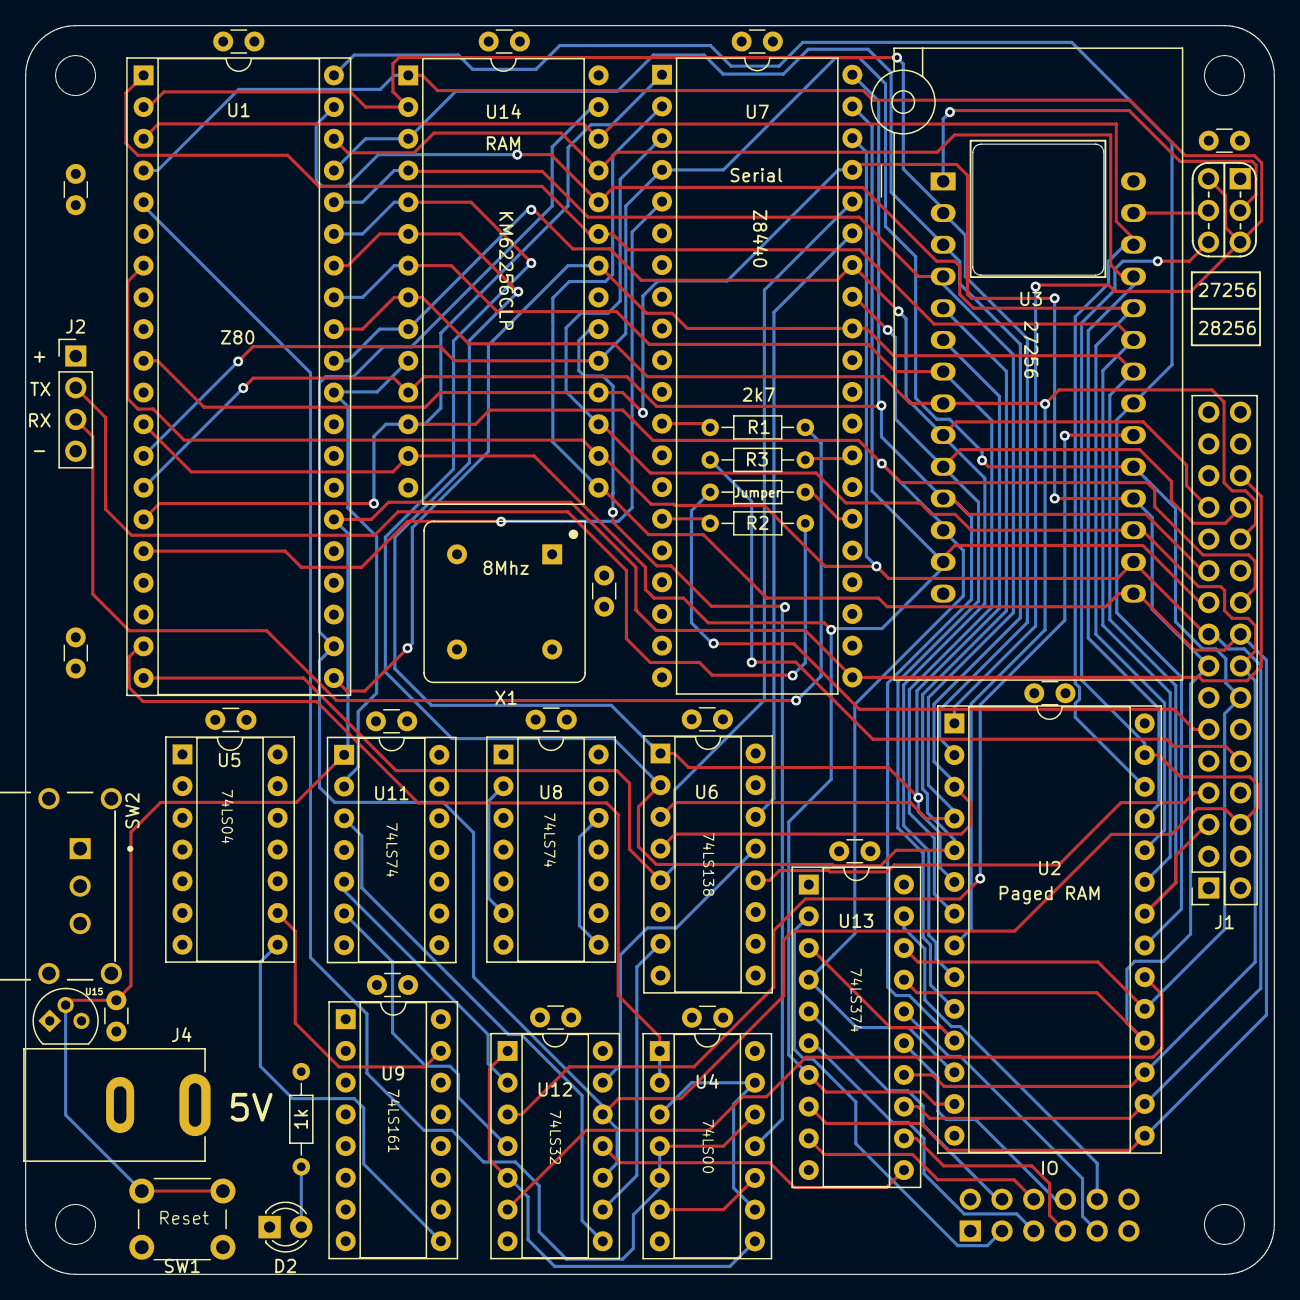
[picture p18: board main_board.kicad_pcb from above]

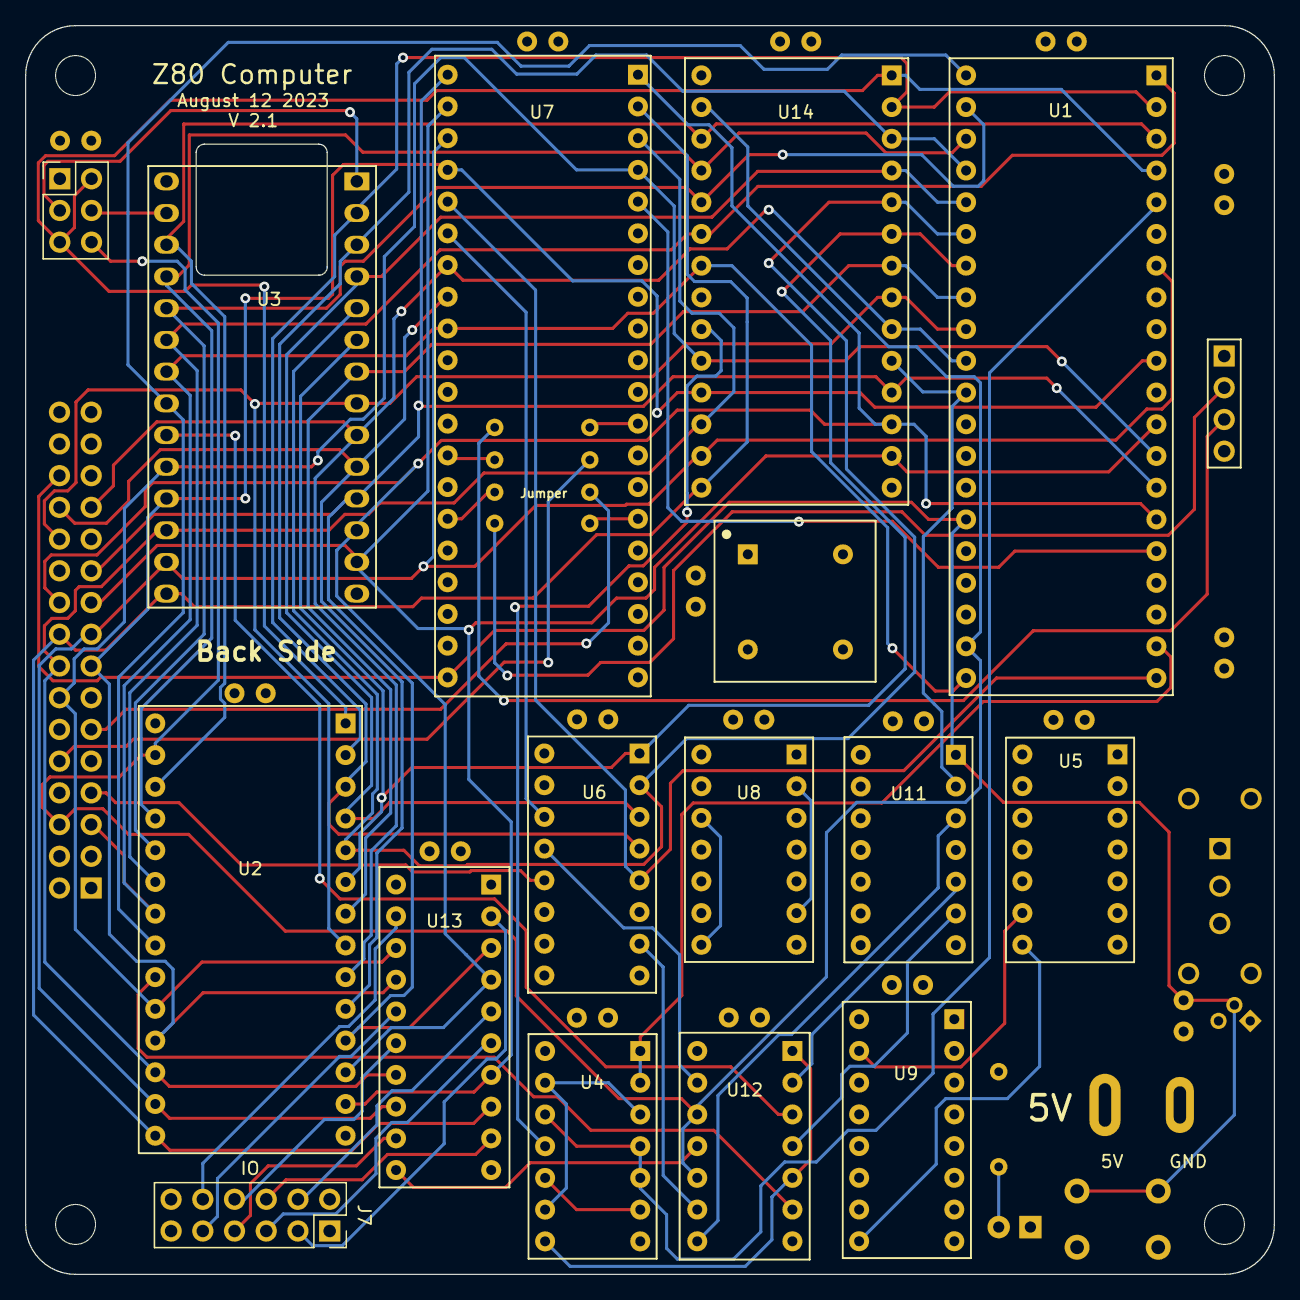
[picture p19: board main_board.kicad_pcb from below]

Board: 4 copper layers, 100.0 x 100.0 mm, 49 parts (2 on the bottom side), 75 nets.
