ashlin4010/simple_Z80_computer/(commit log)

2023-12-16 Added Kicad files
    [CompactFlash-B_Cu.gbl, CompactFlash-B_Mask.gbs, CompactFlash-B_Silkscreen.gbo, CompactFlash-Edge_Cuts.gm1, CompactFlash-F_Cu.gtl, CompactFlash-F_Mask.gts, CompactFlash-F_Silkscreen.gto, CompactFlash-NPTH-drl_map.gbr]
2023-12-16 More README
    [main_board.kicad_sch]
2023-12-17 Added pi install instructions
    [CompactFlash-B_Cu.gbl, CompactFlash-B_Mask.gbs, CompactFlash-B_Silkscreen.gbo, CompactFlash-Edge_Cuts.gm1, CompactFlash-F_Cu.gtl, CompactFlash-F_Mask.gts, CompactFlash-F_Silkscreen.gto, CompactFlash-NPTH-drl_map.gbr]
2023-12-19 Added BOM
2023-12-28 Fixed UART init Started on serial boot loader Experimenting with libraries Started on boot loader server
    [main.py, monitor.z80.asm, sboot.z80.asm, sboot_entry.z80.asm]
